BenjaminHab/mad-fine-scale/hardware/Scale.kicad_pcb

## KiCad design hardware/Scale.kicad_pcb (2025-12-04)

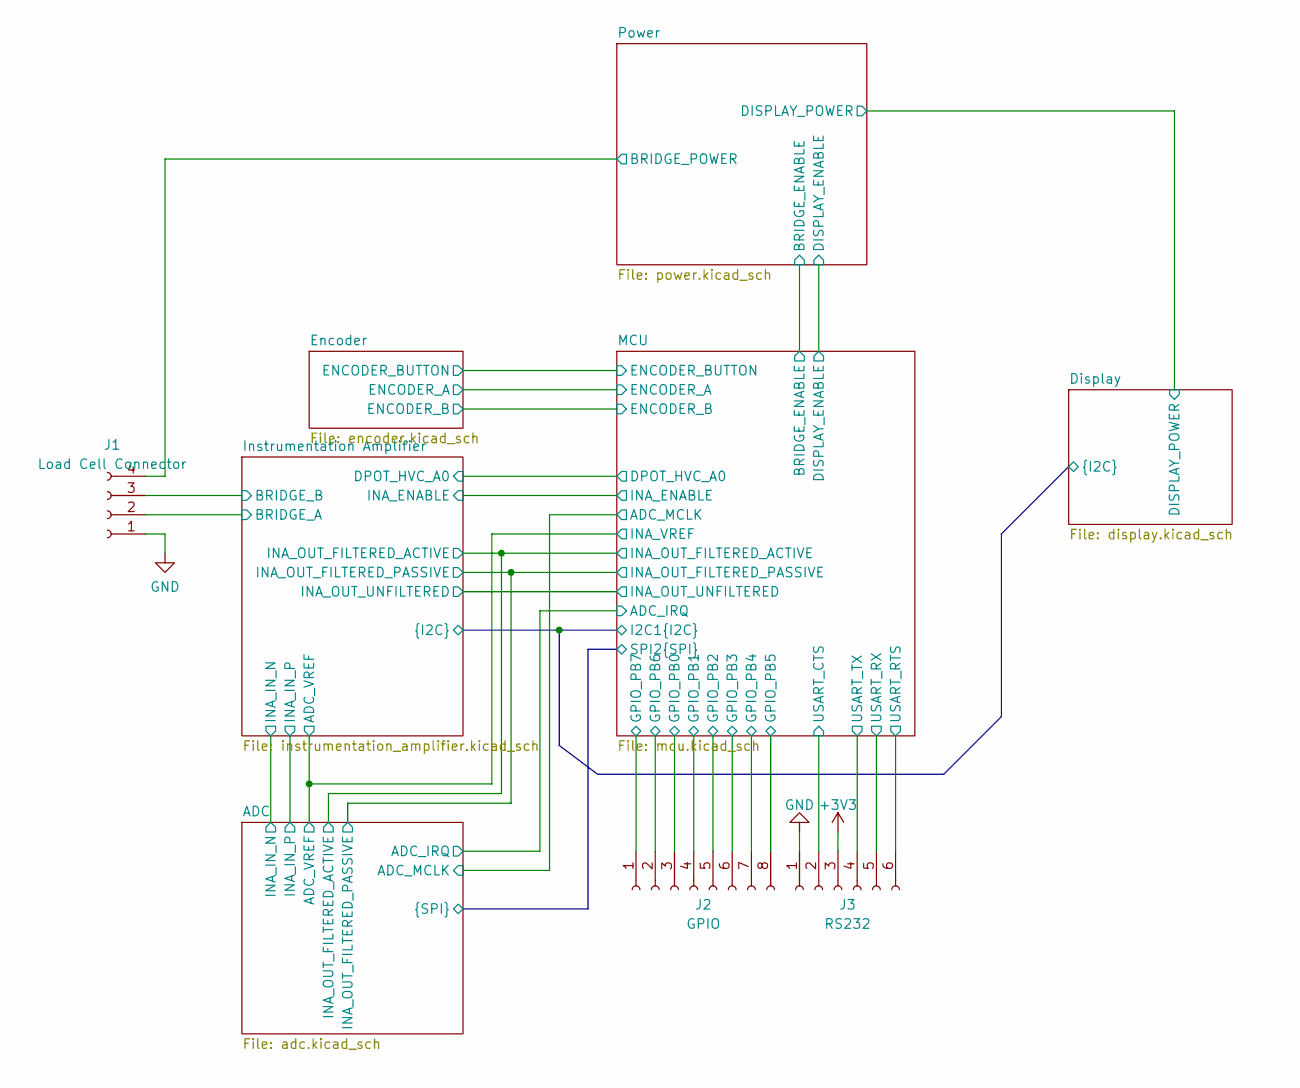
[picture p1: schematic Scale.kicad_sch]

Parts:
J1: Load Cell Connector; PinHeader_1x04_P2.54mm_Vertical
J2: GPIO; PinHeader_1x08_P2.54mm_Vertical
J3: RS232; PinHeader_1x06_P2.54mm_Vertical

Connections:
+3V3: J3.3; also elsewhere on the board
/Instrumentation Amplifier/BRIDGE_A: J1.2; also elsewhere on the board
/Instrumentation Amplifier/BRIDGE_B: J1.3; also elsewhere on the board
/MCU/GPIO_PB0: J2.3; also elsewhere on the board
/MCU/GPIO_PB1: J2.4; also elsewhere on the board
/MCU/GPIO_PB2: J2.5; also elsewhere on the board
/MCU/GPIO_PB3: J2.6; also elsewhere on the board
/MCU/GPIO_PB4: J2.7; also elsewhere on the board
/MCU/GPIO_PB5: J2.8; also elsewhere on the board
/MCU/GPIO_PB6: J2.2; also elsewhere on the board
/MCU/GPIO_PB7: J2.1; also elsewhere on the board
/MCU/USART_CTS: J3.2; also elsewhere on the board
/MCU/USART_RTS: J3.6; also elsewhere on the board
/MCU/USART_RX: J3.5; also elsewhere on the board
/MCU/USART_TX: J3.4; also elsewhere on the board
/Power/BRIDGE_POWER: J1.4; also elsewhere on the board
GND: J1.1, J3.1; also elsewhere on the board

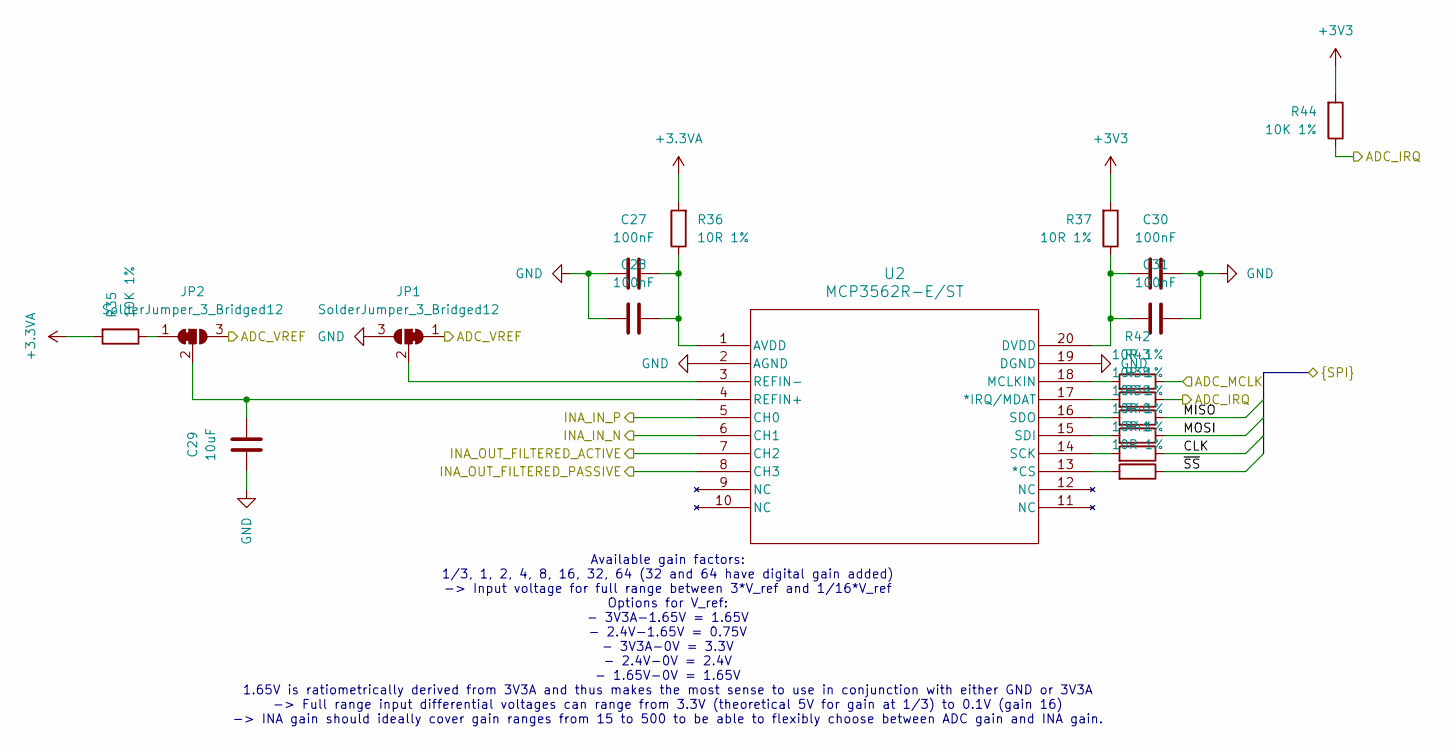
[picture p2: schematic adc.kicad_sch]

Parts:
C27, C28, C30, C31: 100nF; C_0603_1608Metric
C29: 10uF; C_0603_1608Metric
JP1, JP2: SolderJumper_3_Bridged12; SolderJumper-3_P1.3mm_Bridged2Bar12_RoundedPad1.0x1.5mm
R35, R44: 10K 1%; R_0603_1608Metric
R36, R37, R38, R39, R40, R41, R42, R43: 10R 1%; R_0603_1608Metric
U2: MCP3562R-E/ST; TSSOP-20_4.4x6.5mm_P0.65mm

Connections:
+3.3VA: R35.2, R36.2; also elsewhere on the board
+3V3: R37.2, R44.2; also elsewhere on the board
/ADC/ADC_IRQ: R43.1, R44.1; also elsewhere on the board
/ADC/ADC_MCLK: R42.1; also elsewhere on the board
/ADC/ADC_VREF: JP1.1 (A), JP2.3 (B); also elsewhere on the board
/ADC/CLK: R40.1; also elsewhere on the board
/ADC/INA_OUT_FILTERED_ACTIVE: U2.7 (CH2); also elsewhere on the board
/ADC/INA_OUT_FILTERED_PASSIVE: U2.8 (CH3); also elsewhere on the board
/ADC/MISO: R38.1; also elsewhere on the board
/ADC/MOSI: R39.1; also elsewhere on the board
/ADC/~SS: R41.1; also elsewhere on the board
/Instrumentation Amplifier/INA_IN_N: U2.6 (CH1); also elsewhere on the board
/Instrumentation Amplifier/INA_IN_P: U2.5 (CH0); also elsewhere on the board
GND: C27.1, C28.1, C29.1, C30.1, C31.1, JP1.3 (B), U2.2 (AGND), U2.19 (DGND); also elsewhere on the board
unnamed: JP1.2 (C), U2.3 (REFIN-)
unnamed: JP2.1 (A), R35.1
unnamed: C29.2, JP2.2 (C), U2.4 (REFIN+)
unnamed: R41.2, U2.13 (*CS)
unnamed: R43.2, U2.17 (*IRQ/MDAT)
unnamed: C27.2, C28.2, R36.1, U2.1 (AVDD)
unnamed: C30.2, C31.2, R37.1, U2.20 (DVDD)
unnamed: R42.2, U2.18 (MCLKIN)
unnamed: R40.2, U2.14 (SCK)
unnamed: R39.2, U2.15 (SDI)
unnamed: R38.2, U2.16 (SDO)

Notes on the sheet:
Available gain factors: 1/3, 1, 2, 4, 8, 16, 32, 64 (32 and 64 have digital gain added) -> Input voltage for full range between 3*V_ref and 1/16*V_ref Options for V_ref: - 3V3A-1.65V = 1.65V - 2.4V-1.65V = 0.75V - 3V3A-0V = 3.3V - 2.4V-0V = 2.4V - 1.65V-0V = 1.65V 1.65V is ratiometrically derived f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

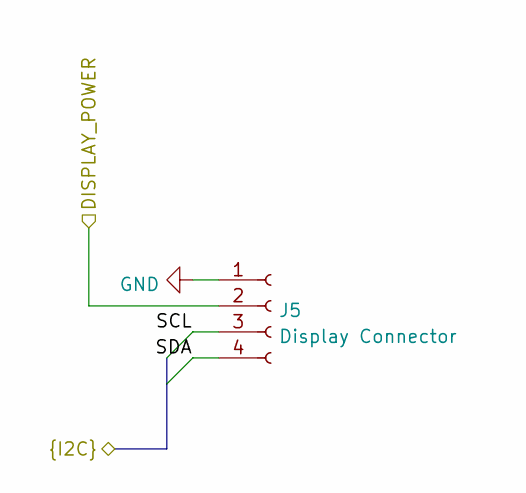
[picture p3: schematic display.kicad_sch]

Parts:
J5: Display Connector; PinHeader_1x04_P2.54mm_Vertical

Connections:
/Display/DISPLAY_POWER: J5.2; also elsewhere on the board
/Display/SCL: J5.3; also elsewhere on the board
/Display/SDA: J5.4; also elsewhere on the board
GND: J5.1; also elsewhere on the board

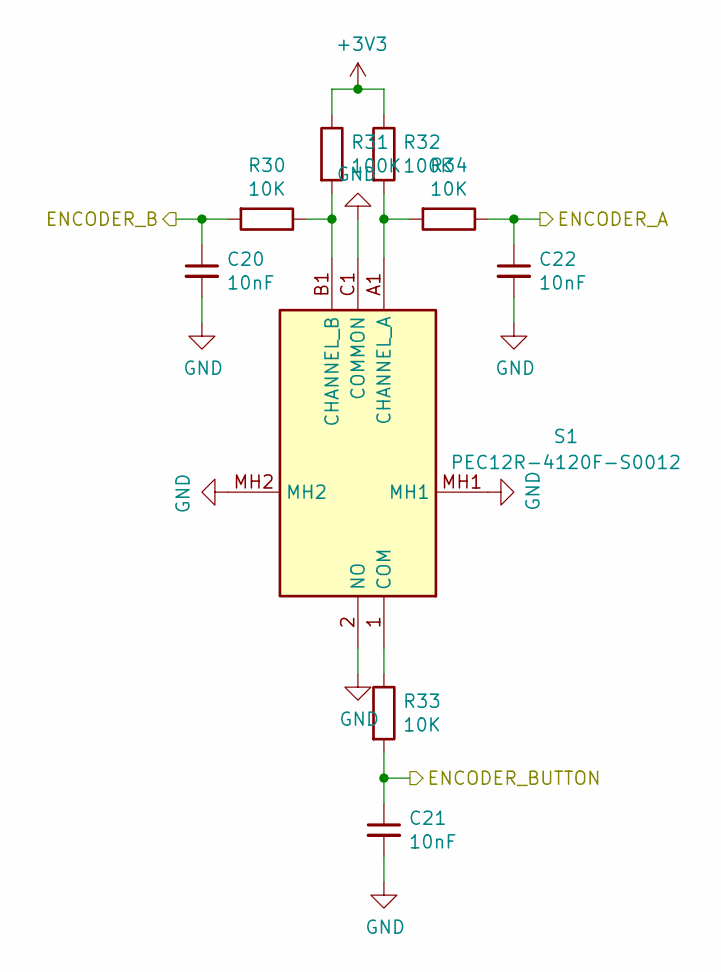
[picture p4: schematic encoder.kicad_sch]

Parts:
C20, C21, C22: 10nF; C_0603_1608Metric
R30, R33, R34: 10K; R_0603_1608Metric
R31, R32: 100K; R_0603_1608Metric
S1: PEC12R-4120F-S0012; PEC12R3217FS0024; Manufacturer_Part_Number PEC12R-3217F-S0024; Mouser Part Number 652-PEC12R3217FS0024

Connections:
+3V3: R31.1, R32.1; also elsewhere on the board
/Encoder/ENCODER_A: C22.1, R34.1; also elsewhere on the board
/Encoder/ENCODER_B: C20.1, R30.2; also elsewhere on the board
/Encoder/ENCODER_BUTTON: C21.1, R33.2; also elsewhere on the board
GND: C20.2, C21.2, C22.2, S1.2 (NO), S1.C1 (COMMON), S1.MH1, S1.MH2; also elsewhere on the board
unnamed: R32.2, R34.2, S1.A1 (CHANNEL_A)
unnamed: R30.1, R31.2, S1.B1 (CHANNEL_B)
unnamed: R33.1, S1.1 (COM)

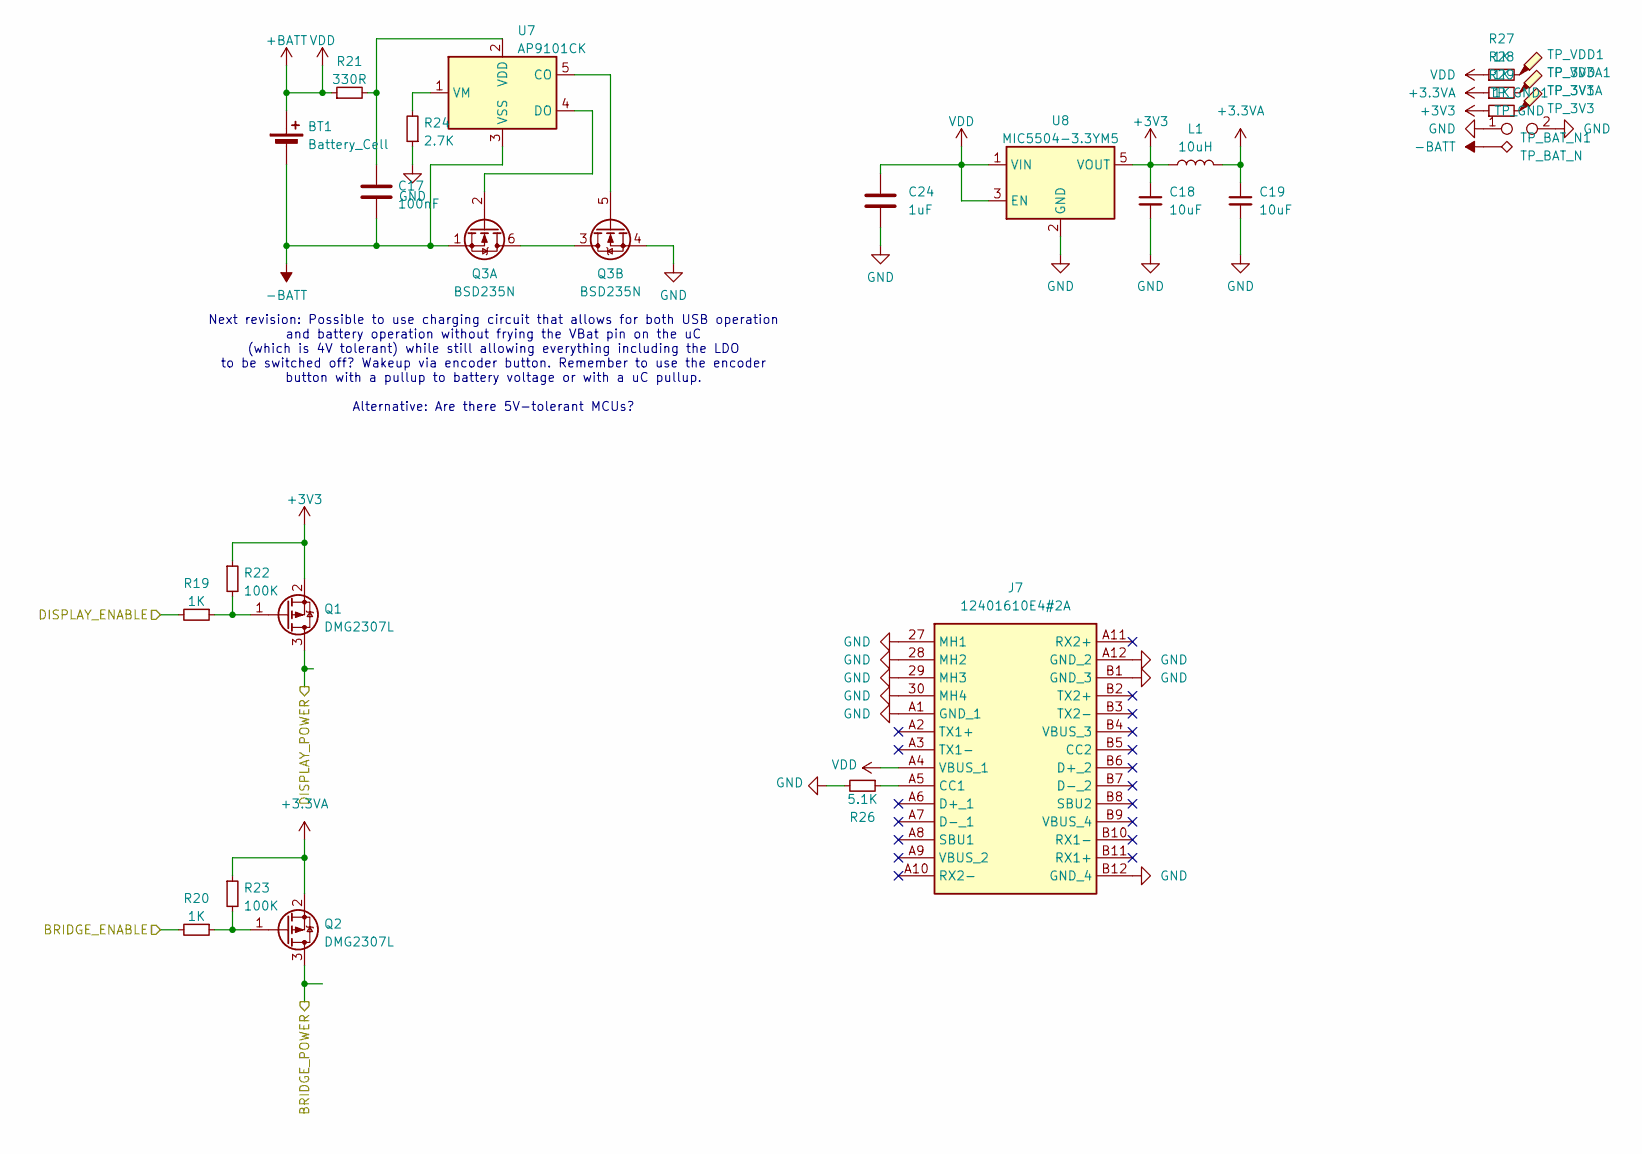
[picture p5: schematic power.kicad_sch]

Parts:
BT1: Battery_Cell; JST_PH_B2B-PH-K_1x02_P2.00mm_Vertical
C17: 100nF; C_0603_1608Metric
C18, C19: 10uF; C_1210_3225Metric
C24: 1uF; C_0603_1608Metric
J7: 12401610E4#2A; 12401610E42A; Manufacturer_Part_Number 12401610E4#2A
L1: 10uH; L_1210_3225Metric
Q1, Q2: DMG2307L; SOT-23
Q3: BSD235N; SOT-363_SC-70-6; MPN BSD235N
R19, R20, R27, R28, R29: 1K; R_0603_1608Metric
R21: 330R; R_0603_1608Metric
R22, R23: 100K; R_0603_1608Metric
R24: 2.7K; R_0603_1608Metric
R26: 5.1K; R_0603_1608Metric
TP_3V1: TP_3V3; TestPoint_Pad_D1.5mm
TP_3V3A1: TP_3V3A; TestPoint_Pad_D1.5mm
TP_BAT_N1: TP_BAT_N; TestPoint_Pad_D1.5mm
TP_GND1: TP_GND; R_0805_2012Metric
TP_VDD1: TP_VDD; TestPoint_Pad_D1.5mm
U7: AP9101CK; SOT-23-5; MPN AP9101CK-AHTRG1
U8: MIC5504-3.3YM5; SOT-23-5; MPN MIC5504-3.3YM5-TR

Connections:
+3.3VA: C19.1, L1.2, Q2.2 (S), R23.1, R28.1; also elsewhere on the board
+3V3: C18.1, L1.1, Q1.2 (S), R22.1, R29.1, U8.5 (VOUT); also elsewhere on the board
+BATT: BT1.1 (+), C24.2, J7.A4 (VBUS_1), R21.1, R27.1, U8.1 (VIN), U8.3 (EN)
-BATT: BT1.2 (-), C17.2, Q3.1 (S), TP_BAT_N1.1, U7.3 (VSS)
/Display/DISPLAY_POWER: Q1.3 (D); also elsewhere on the board
/MCU/BRIDGE_ENABLE: R20.2; also elsewhere on the board
/MCU/DISPLAY_ENABLE: R19.2; also elsewhere on the board
/Power/BRIDGE_POWER: Q2.3 (D); also elsewhere on the board
GND: C18.2, C19.2, C24.1, J7.27 (MH1), J7.28 (MH2), J7.29 (MH3), J7.30 (MH4), J7.A1 (GND_1), J7.A12 (GND_2), J7.B1 (GND_3), J7.B12 (GND_4), Q3.4 (S), R24.1, R26.2, TP_GND1.1, TP_GND1.2, U8.2 (GND); also elsewhere on the board
unnamed: J7.A5 (CC1), R26.1
unnamed: Q1.1 (G), R19.1, R22.2
unnamed: Q2.1 (G), R20.1, R23.2
unnamed: Q3.3 (D), Q3.6 (D)
unnamed: Q3.2 (G), U7.4 (DO)
unnamed: Q3.5 (G), U7.5 (CO)
unnamed: R27.2, TP_VDD1.1
unnamed: R28.2, TP_3V3A1.1
unnamed: R29.2, TP_3V1.1
unnamed: C17.1, R21.2, U7.2 (VDD)
unnamed: R24.2, U7.1 (VM)

Notes on the sheet:
Next revision: Possible to use charging circuit that allows for both USB operation and battery operation without frying the VBat pin on the uC (which is 4V tolerant) while still allowing everything including the LDO to be switched off? Wakeup via encoder button. Remember to use the encoder button w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

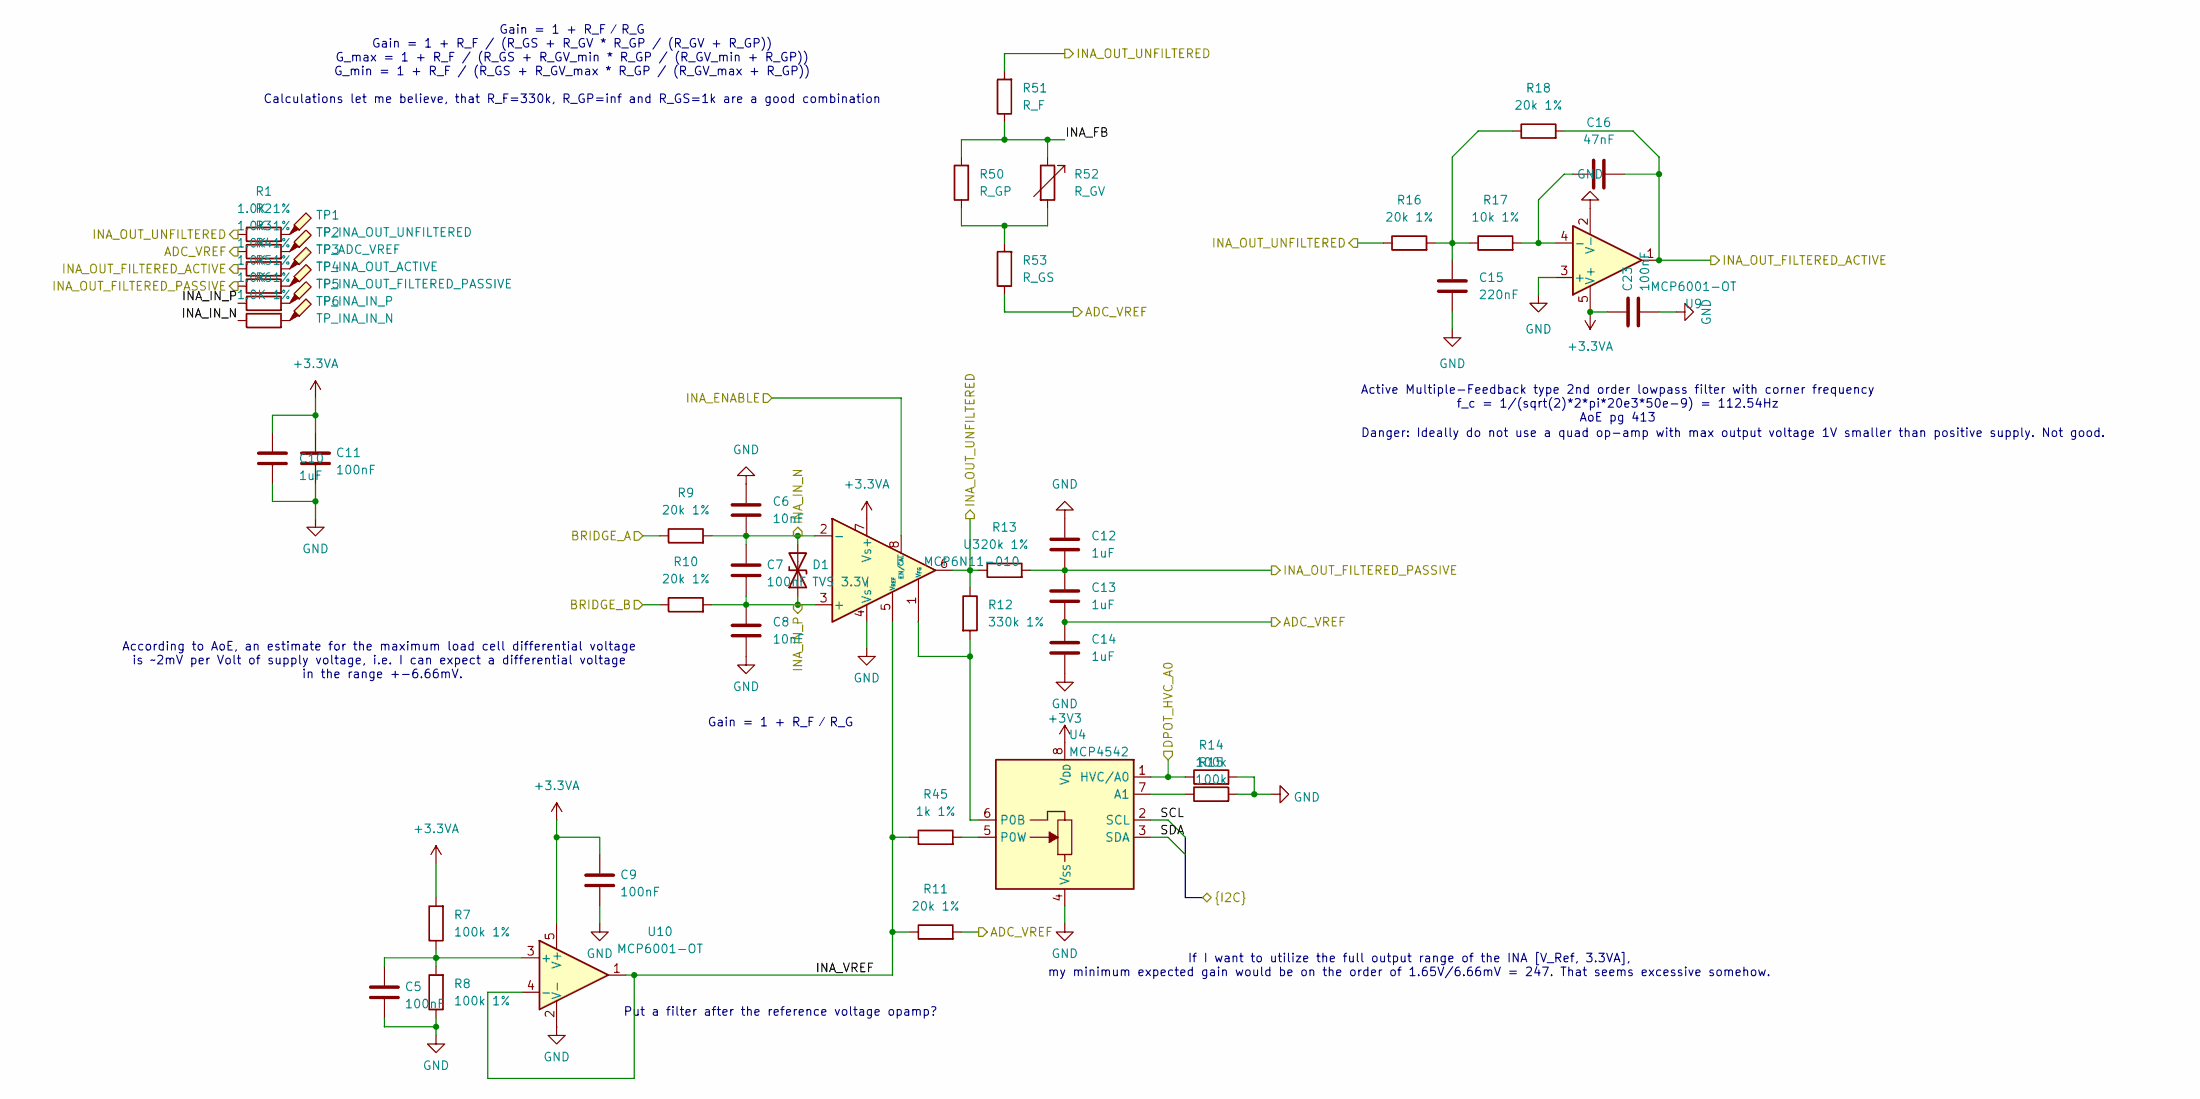
[picture p6: schematic instrumentation_amplifier.kicad_sch]

Parts:
C5, C7, C9, C11, C23: 100nF; C_0603_1608Metric
C6, C8: 10nF; C_0603_1608Metric
C10, C12, C13, C14: 1uF; C_0603_1608Metric
C15: 220nF; C_0603_1608Metric
C16: 47nF; C_0603_1608Metric
D1: TVS 3.3V; D_SOD-323F; MPN CDSOD323-T03
R1, R2, R3, R4, R5, R6: 1.0K 1%; R_0603_1608Metric
R7, R8: 100k 1%; R_0603_1608Metric
R9, R10, R11, R13, R16, R18: 20k 1%; R_0603_1608Metric
R12: 330k 1%; R_0603_1608Metric
R14, R15: 100k; R_0603_1608Metric
R17: 10k 1%; R_0603_1608Metric
R45: 1k 1%; R_0603_1608Metric
R50: R_GP; R_0603_1608Metric
R51: R_F; R_0603_1608Metric
R52: R_GV
R53: R_GS; R_0603_1608Metric
TP1: TP_INA_OUT_UNFILTERED; TestPoint_Pad_D1.5mm
TP2: TP_ADC_VREF; TestPoint_Pad_D1.5mm
TP3: TP_INA_OUT_ACTIVE; TestPoint_Pad_D1.5mm
TP4: TP_INA_OUT_FILTERED_PASSIVE; TestPoint_Pad_D1.5mm
TP5: TP_INA_IN_P; TestPoint_Pad_D1.5mm
TP6: TP_INA_IN_N; TestPoint_Pad_D1.5mm
U3: MCP6N11-010; SOIC-8_3.9x4.9mm_P1.27mm; MPN MCP6N11-010
U4: MCP4542; MSOP-8_3x3mm_P0.65mm; MPN MCP4542-103E/MS
U9, U10: MCP6001-OT; SOT-23-5

Connections:
+3.3VA: C9.1, C10.1, C11.1, C23.1, R7.2, U3.7 (Vs+), U9.5 (V+), U10.5 (V+); also elsewhere on the board
+3V3: U4.8 (V_{DD}); also elsewhere on the board
/ADC/ADC_VREF: C13.2, C14.1, R2.1, R11.2, R53.1; also elsewhere on the board
/ADC/INA_OUT_FILTERED_ACTIVE: C16.2, R3.1, R18.2, U9.1; also elsewhere on the board
/ADC/INA_OUT_FILTERED_PASSIVE: C12.2, C13.1, R4.1, R13.2; also elsewhere on the board
/Display/SCL: U4.2 (SCL); also elsewhere on the board
/Display/SDA: U4.3 (SDA); also elsewhere on the board
/Instrumentation Amplifier/BRIDGE_A: R9.1; also elsewhere on the board
/Instrumentation Amplifier/BRIDGE_B: R10.1; also elsewhere on the board
/Instrumentation Amplifier/DPOT_HVC_A0: R14.1, U4.1 (HVC/A0); also elsewhere on the board
/Instrumentation Amplifier/INA_ENABLE: U3.8 (EN/~CAL); also elsewhere on the board
/Instrumentation Amplifier/INA_IN_N: C6.2, C7.1, D1.2 (A2), R6.1, R9.2, U3.2 (-); also elsewhere on the board
/Instrumentation Amplifier/INA_IN_P: C7.2, C8.1, D1.1 (A1), R5.1, R10.2, U3.3 (+); also elsewhere on the board
/Instrumentation Amplifier/INA_OUT_UNFILTERED: R1.1, R12.1, R13.1, R16.1, R51.2, U3.6; also elsewhere on the board
/Instrumentation Amplifier/INA_VREF: R11.1, R45.1, U3.5 (V_{REF}), U10.1, U10.4 (-)
GND: C5.2, C6.1, C8.2, C9.2, C10.2, C11.2, C12.1, C14.2, C15.2, C23.2, R8.1, R14.2, R15.2, U3.4 (Vs-), U4.4 (V_{SS}), U9.2 (V-), U9.3 (+), U10.2 (V-); also elsewhere on the board
unnamed: C15.1, R16.2, R17.1, R18.1
unnamed: R1.2, TP1.1
unnamed: R2.2, TP2.1
unnamed: R3.2, TP3.1
unnamed: R4.2, TP4.1
unnamed: R5.2, TP5.1
unnamed: R6.2, TP6.1
unnamed: R50.1, R52.2, R53.2
unnamed: R50.2, R51.1, R52.1
unnamed: R12.2, U3.1 (V_{FG}), U4.6 (P0B)
unnamed: R15.1, U4.7 (A1)
unnamed: R45.2, U4.5 (P0W)
unnamed: C16.1, R17.2, U9.4 (-)
unnamed: C5.1, R7.1, R8.2, U10.3 (+)

Notes on the sheet:
Gain = 1 + R_F ⁄ R_G Gain = 1 + R_F / (R_GS + R_GV * R_GP / (R_GV + R_GP)) G_max = 1 + R_F / (R_GS + R_GV_min * R_GP / (R_GV_min + R_GP)) G_min = 1 + R_F / (R_GS + R_GV_max * R_GP / (R_GV_max + R_GP)) Calculations let me believe, that R_F=330k, R_GP=inf and R_GS=1k are a good combination
According to AoE, an estimate for the maximum load cell differential voltage is ~2mV per Volt of supply voltage, i.e. I can expect a differential voltage in the range +-6.66mV.
Gain = 1 + R_F ⁄ R_G
Danger: Ideally do not use a quad op-amp with max output voltage 1V smaller than positive supply. Not good.
Put a filter after the reference voltage opamp?
If I want to utilize the full output range of the INA [V_Ref, 3.3VA], my minimum expected gain would be on the order of 1.65V/6.66mV = 247. That seems excessive somehow.
Active Multiple-Feedback type 2nd order lowpass filter with corner frequency f_c = 1/(sqrt(2)*2*pi*20e3*50e-9) = 112.54Hz AoE pg 413

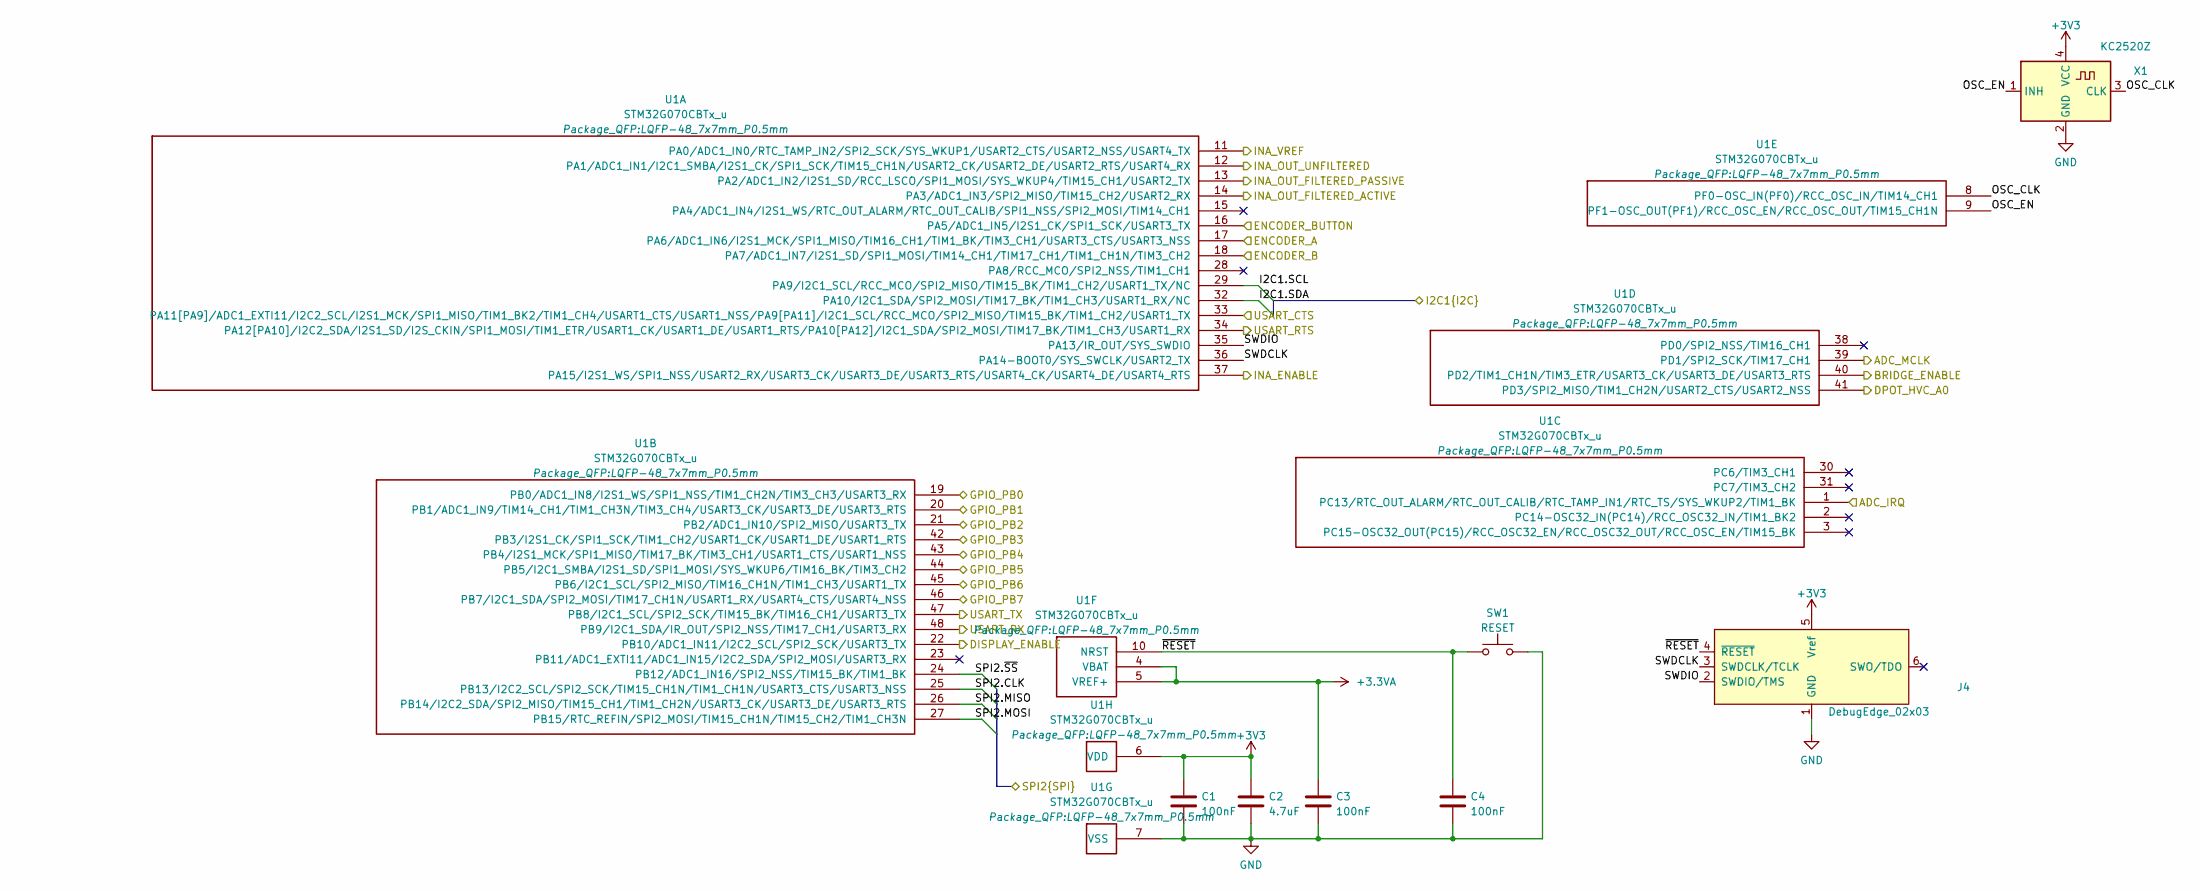
[picture p7: schematic mcu.kicad_sch]

Parts:
C1, C3, C4: 100nF; C_0603_1608Metric
C2: 4.7uF; C_0603_1608Metric
J4: DebugEdge_02x03; DebugEdge_2x03_Target
SW1: RESET; SW_Push_1P1T_NO_CK_KMR2
U1: STM32G070CBTx_u; LQFP-48_7x7mm_P0.5mm
X1: KC2520Z; Oscillator_SMD_Kyocera_KC2520Z-4Pin_2.5x2.0mm; MPN KC2520Z48.0000C1KX00

Connections:
+3.3VA: C3.1, U1.4 (VBAT), U1.5 (VREF+); also elsewhere on the board
+3V3: C1.1, C2.1, J4.5 (Vref), U1.6 (VDD), X1.4 (VCC); also elsewhere on the board
/ADC/ADC_IRQ: U1.1 (PC13/RTC_OUT_ALARM/RTC_OUT_CALIB/RTC_TA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); also elsewhere on the board
/ADC/ADC_MCLK: U1.39 (PD1/SPI2_SCK/TIM17_CH1); also elsewhere on the board
/ADC/ADC_VREF: U1.11 (PA0/ADC1_IN0/RTC_TAMP_IN2/SPI2_SCK/SYS_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); also elsewhere on the board
/ADC/CLK: U1.25 (PB13/I2C2_SCL/SPI2_SCK/TIM15_CH1N/TIM1_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); also elsewhere on the board
/ADC/INA_OUT_FILTERED_ACTIVE: U1.14 (PA3/ADC1_IN3/SPI2_MISO/TIM15_CH2/USART2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); also elsewhere on the board
/ADC/INA_OUT_FILTERED_PASSIVE: U1.13 (PA2/ADC1_IN2/I2S1_SD/RCC_LSCO/SPI1_MOSI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); also elsewhere on the board
/ADC/MISO: U1.26 (PB14/I2C2_SDA/SPI2_MISO/TIM15_CH1/TIM1_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); also elsewhere on the board
/ADC/MOSI: U1.27 (PB15/RTC_REFIN/SPI2_MOSI/TIM15_CH1N/TIM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); also elsewhere on the board
/ADC/~SS: U1.24 (PB12/ADC1_IN16/SPI2_NSS/TIM15_BK/TIM1_BK); also elsewhere on the board
/Display/SCL: U1.29 (PA9/I2C1_SCL/RCC_MCO/SPI2_MISO/TIM15_BK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); also elsewhere on the board
/Display/SDA: U1.32 (PA10/I2C1_SDA/SPI2_MOSI/TIM17_BK/TIM1_C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); also elsewhere on the board
/Encoder/ENCODER_A: U1.17 (PA6/ADC1_IN6/I2S1_MCK/SPI1_MISO/TIM16_C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); also elsewhere on the board
/Encoder/ENCODER_B: U1.18 (PA7/ADC1_IN7/I2S1_SD/SPI1_MOSI/TIM14_CH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); also elsewhere on the board
/Encoder/ENCODER_BUTTON: U1.16 (PA5/ADC1_IN5/I2S1_CK/SPI1_SCK/USART3_TX); also elsewhere on the board
/Instrumentation Amplifier/DPOT_HVC_A0: U1.41 (PD3/SPI2_MISO/TIM1_CH2N/USART2_CTS/USAR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); also elsewhere on the board
/Instrumentation Amplifier/INA_ENABLE: U1.37 (PA15/I2S1_WS/SPI1_NSS/USART2_RX/USART3_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); also elsewhere on the board
/Instrumentation Amplifier/INA_OUT_UNFILTERED: U1.12 (PA1/ADC1_IN1/I2C1_SMBA/I2S1_CK/SPI1_SCK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); also elsewhere on the board
/MCU/BRIDGE_ENABLE: U1.40 (PD2/TIM1_CH1N/TIM3_ETR/USART3_CK/USART3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); also elsewhere on the board
/MCU/DISPLAY_ENABLE: U1.22 (PB10/ADC1_IN11/I2C2_SCL/SPI2_SCK/USART3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); also elsewhere on the board
/MCU/GPIO_PB0: U1.19 (PB0/ADC1_IN8/I2S1_WS/SPI1_NSS/TIM1_CH2N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); also elsewhere on the board
/MCU/GPIO_PB1: U1.20 (PB1/ADC1_IN9/TIM14_CH1/TIM1_CH3N/TIM3_C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); also elsewhere on the board
/MCU/GPIO_PB2: U1.21 (PB2/ADC1_IN10/SPI2_MISO/USART3_TX); also elsewhere on the board
/MCU/GPIO_PB3: U1.42 (PB3/I2S1_CK/SPI1_SCK/TIM1_CH2/USART1_CK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); also elsewhere on the board
/MCU/GPIO_PB4: U1.43 (PB4/I2S1_MCK/SPI1_MISO/TIM17_BK/TIM3_CH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); also elsewhere on the board
/MCU/GPIO_PB5: U1.44 (PB5/I2C1_SMBA/I2S1_SD/SPI1_MOSI/SYS_WKU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); also elsewhere on the board
/MCU/GPIO_PB6: U1.45 (PB6/I2C1_SCL/SPI2_MISO/TIM16_CH1N/TIM1_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); also elsewhere on the board
/MCU/GPIO_PB7: U1.46 (PB7/I2C1_SDA/SPI2_MOSI/TIM17_CH1N/USART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); also elsewhere on the board
/MCU/OSC_CLK: U1.8 (PF0-OSC_IN(PF0)/RCC_OSC_IN/TIM14_CH1), X1.3 (CLK)
/MCU/OSC_EN: U1.9 (PF1-OSC_OUT(PF1)/RCC_OSC_EN/RCC_OSC_OUT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), X1.1 (INH)
/MCU/SWDCLK: J4.3 (SWDCLK/TCLK), U1.36 (PA14-BOOT0/SYS_SWCLK/USART2_TX)
/MCU/SWDIO: J4.2 (SWDIO/TMS), U1.35 (PA13/IR_OUT/SYS_SWDIO)
/MCU/USART_CTS: U1.33 (PA11[PA9]/ADC1_EXTI11/I2C2_SCL/I2S1_MCK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); also elsewhere on the board
/MCU/USART_RTS: U1.34 (PA12[PA10]/I2C2_SDA/I2S1_SD/I2S_CKIN/SP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); also elsewhere on the board
/MCU/USART_RX: U1.48 (PB9/I2C1_SDA/IR_OUT/SPI2_NSS/TIM17_CH1/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); also elsewhere on the board
/MCU/USART_TX: U1.47 (PB8/I2C1_SCL/SPI2_SCK/TIM15_BK/TIM16_CH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); also elsewhere on the board
/MCU/~RESET: C4.1, J4.4 (~RESET), SW1.1, U1.10 (NRST)
GND: C1.2, C2.2, C3.2, C4.2, J4.1 (GND), SW1.2, U1.7 (VSS), X1.2 (GND); also elsewhere on the board

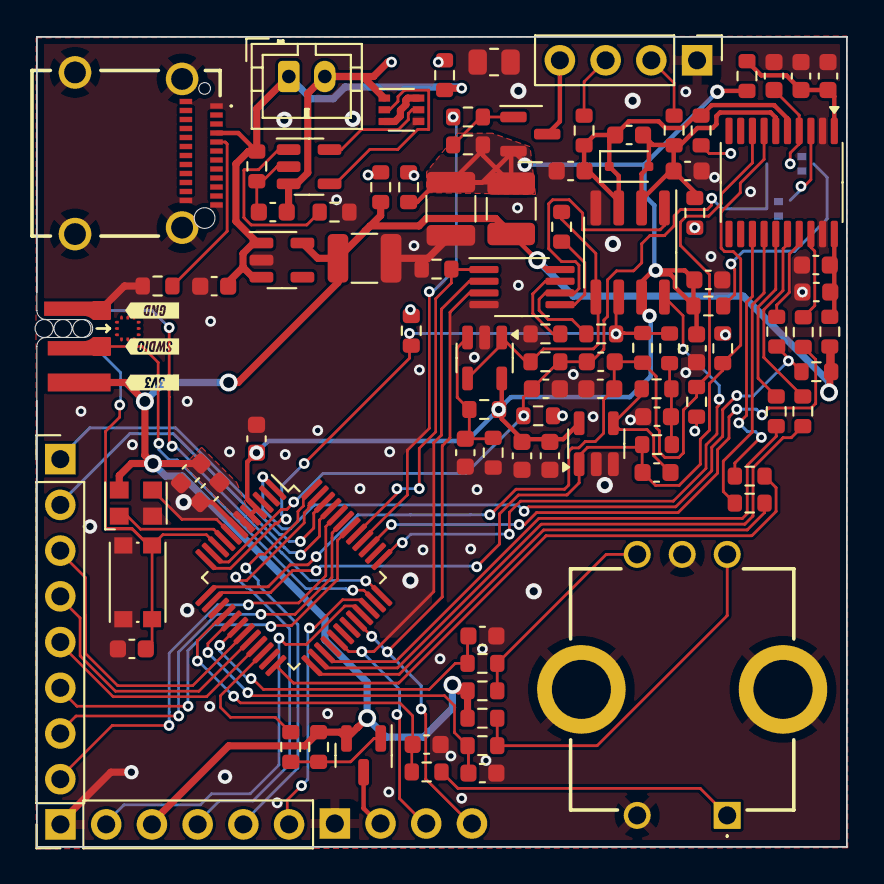
[picture p8: board Scale.kicad_pcb from above]

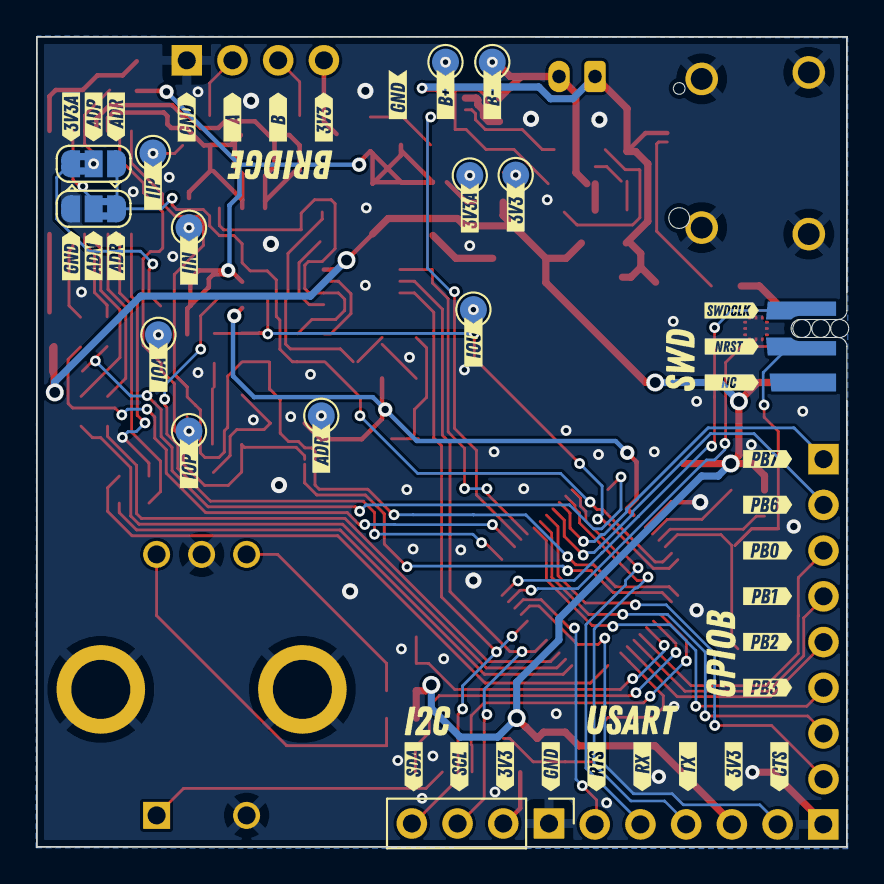
[picture p9: board Scale.kicad_pcb from below]

Board: 2 copper layers, 45.0 x 45.0 mm, 158 parts (59 on the bottom side), 85 nets.

Other parts of the board:
kibuzzard-69235A0F: G***; kibuzzard-69235A0F
kibuzzard-69235A05: G***; kibuzzard-69235A05
kibuzzard-69235A65: G***; kibuzzard-69235A65
kibuzzard-69235A78: G***; kibuzzard-69235A78
kibuzzard-69235A81: G***; kibuzzard-69235A81
kibuzzard-69235C2C: G***; kibuzzard-69235C2C
kibuzzard-69235C3D: G***; kibuzzard-69235C3D
kibuzzard-69235C19: G***; kibuzzard-69235C19
kibuzzard-69235C25: G***; kibuzzard-69235C25
kibuzzard-69235C31: G***; kibuzzard-69235C31
kibuzzard-69235C43: G***; kibuzzard-69235C43
kibuzzard-69235C86: G***; kibuzzard-69235C86
kibuzzard-69235CAB: G***; kibuzzard-69235CAB
kibuzzard-69235CD0: G***; kibuzzard-69235CD0
kibuzzard-69235CE7: G***; kibuzzard-69235CE7
kibuzzard-69235D1A: G***; kibuzzard-69235D1A
kibuzzard-69235D2C: G***; kibuzzard-69235D2C
kibuzzard-69235D7B: G***; kibuzzard-69235D7B
kibuzzard-69235D46: G***; kibuzzard-69235D46
kibuzzard-69235D61: G***; kibuzzard-69235D61
kibuzzard-69235D70: G***; kibuzzard-69235D70
kibuzzard-69235D86: G***; kibuzzard-69235D86
kibuzzard-69235DBF: G***; kibuzzard-69235DBF
kibuzzard-69235DD0: G***; kibuzzard-69235DD0
kibuzzard-69235DDD: G***; kibuzzard-69235DDD
kibuzzard-69235DE8: G***; kibuzzard-69235DE8
kibuzzard-69235E1A: G***; kibuzzard-69235E1A
kibuzzard-69235E07: G***; kibuzzard-69235E07
kibuzzard-69235E34: G***; kibuzzard-69235E34
kibuzzard-69235E43: G***; kibuzzard-69235E43
kibuzzard-69235E53: G***; kibuzzard-69235E53
kibuzzard-69235E66: G***; kibuzzard-69235E66
kibuzzard-69235E74: G***; kibuzzard-69235E74
kibuzzard-69235E84: G***; kibuzzard-69235E84
kibuzzard-69235EA0: G***; kibuzzard-69235EA0
kibuzzard-69235EC4: G***; kibuzzard-69235EC4
kibuzzard-69235ED0: G***; kibuzzard-69235ED0
kibuzzard-69235EDC: G***; kibuzzard-69235EDC
kibuzzard-69235EE8: G***; kibuzzard-69235EE8
kibuzzard-69235EF4: G***; kibuzzard-69235EF4
kibuzzard-69235F49: G***; kibuzzard-69235F49
kibuzzard-69235FA0: G***; kibuzzard-69235FA0
kibuzzard-69235FE1: G***; kibuzzard-69235FE1
kibuzzard-692359F1: G***; kibuzzard-692359F1
kibuzzard-692360F1: G***; kibuzzard-692360F1
kibuzzard-69236006: G***; kibuzzard-69236006
kibuzzard-69236027: G***; kibuzzard-69236027
kibuzzard-69236067: G***; kibuzzard-69236067
kibuzzard-69236118: G***; kibuzzard-69236118
