BenjaminHab/mad-fine-scale/software/Core/Inc/main.h

#define ENCODER_BUTTON_Pin GPIO_PIN_0
#define ENCODER_BUTTON_GPIO_Port GPIOA
#define INA_OUT_Pin GPIO_PIN_1
#define INA_OUT_GPIO_Port GPIOA
#define DISPLAY_ENABLE_Pin GPIO_PIN_2
#define DISPLAY_ENABLE_GPIO_Port GPIOA
#define BRIDGE_ENABLE_Pin GPIO_PIN_3
#define BRIDGE_ENABLE_GPIO_Port GPIOA
#define DPOT_HVC_A0_Pin GPIO_PIN_4
#define DPOT_HVC_A0_GPIO_Port GPIOA
#define GPIO_PA5_Pin GPIO_PIN_5
#define GPIO_PA5_GPIO_Port GPIOA
#define ENCODER_A_Pin GPIO_PIN_6
#define ENCODER_A_GPIO_Port GPIOA
#define ENCODER_B_Pin GPIO_PIN_7
#define ENCODER_B_GPIO_Port GPIOA
#define GPIO_PB0_Pin GPIO_PIN_0
#define GPIO_PB0_GPIO_Port GPIOB
#define GPIO_PB1_Pin GPIO_PIN_1
#define GPIO_PB1_GPIO_Port GPIOB
#define GPIO_PB2_Pin GPIO_PIN_2
#define GPIO_PB2_GPIO_Port GPIOB
#define GPIO_PA8_Pin GPIO_PIN_8
#define GPIO_PA8_GPIO_Port GPIOA
#define INA_ENABLE_Pin GPIO_PIN_15
#define INA_ENABLE_GPIO_Port GPIOA
#define GPIO_PB3_Pin GPIO_PIN_3
#define GPIO_PB3_GPIO_Port GPIOB
#define GPIO_PB4_Pin GPIO_PIN_4
#define GPIO_PB4_GPIO_Port GPIOB
#define GPIO_PB5_Pin GPIO_PIN_5
#define GPIO_PB5_GPIO_Port GPIOB
