BenjaminHab/mad-fine-scale/software/Core/Src/main.cpp

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
/* Includes ------------------------------------------------------------------*/
#include "main.h"
#include "adc.h"
#include "i2c.h"
#include "tim.h"
#include "usart.h"
#include "gpio.h"

/* USER CODE BEGIN Includes */
#include "Modules.hpp"
/* USER CODE END Includes */


void SystemClock_Config(void);
/**
  * @brief  The application entry point.
  * @retval int
  */
int main(void)
{
  /* MCU Configuration--------------------------------------------------------*/

  /* Reset of all peripherals, Initializes the Flash interface and the Systick. */
  HAL_Init();

  /* Configure the system clock */
  SystemClock_Config();

  /* Initialize all configured peripherals */
  MX_GPIO_Init();
  MX_TIM3_Init();
  MX_I2C1_Init();
  MX_ADC1_Init();
  MX_USART1_UART_Init();
  /* USER CODE BEGIN 2 */
  HAL_GPIO_WritePin(DPOT_HVC_A0_GPIO_Port, DPOT_HVC_A0_Pin, GPIO_PIN_RESET); // Set A0 pin on the digital potentiometer to get the correct i2c address
  HAL_GPIO_WritePin(DISPLAY_ENABLE_GPIO_Port, DISPLAY_ENABLE_Pin, GPIO_PIN_RESET); // Switch on power for display (pmos -> inv. signal)
  HAL_GPIO_WritePin(BRIDGE_ENABLE_GPIO_Port, BRIDGE_ENABLE_Pin, GPIO_PIN_RESET); // Switch on power for wheatstone bridge (pmos -> inv. signal)
  HAL_GPIO_WritePin(INA_ENABLE_GPIO_Port, INA_ENABLE_Pin, GPIO_PIN_RESET); // Switch off power for instrumentation amp
  HAL_Delay(10);
  HAL_GPIO_WritePin(INA_ENABLE_GPIO_Port, INA_ENABLE_Pin, GPIO_PIN_SET); // Switch on power for instrumentation amp
  HAL_Delay(100);
  //Display_Test display_test;
  ADC_Test adc_test;
  /* USER CODE END 2 */

  /* Infinite loop */
  /* USER CODE BEGIN WHILE */
  while (1)
  {
	  adc_test.perform();
    /* USER CODE END WHILE */

    /* USER CODE BEGIN 3 */
  }
  /* USER CODE END 3 */
}

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
