BenjaminHab/mad-fine-scale/software/Core/Inc/Modules.hpp

#ifndef Modules_hpp
#define Modules_hpp

#include "ADC_Module.hpp"
#include "Menu_Module.hpp"
#include "Display_Module.hpp"
#include "Encoder_Module.hpp"
#include "GPIO_Module.hpp"
#include "Init_Modules.hpp"
#include "LED_Module.hpp"
#include "Peripherals_Module.hpp"
#include "Statemachine_Module.hpp"
#include "Test_Module.hpp"
#include "RCC_Module.hpp"

#endif
