BenjaminHab/mad-fine-scale/(commit log)

2022-06-05 Fixed Display: At fault was the output speed of the i2c pins
    [Init_Modules.cpp, Test_Module.cpp, mad-fine-scale.ioc]
2024-03-01 Removed build files from index, first experiments with rust
    [Scale-Edge_Cuts.dxf, Scale-F_Paste.dxf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]
2025-07-11 Add todos and try to talk to rheo on i2c
2025-07-14 Fix compiler warning about unused results
    [main.rs]
2025-07-14 Get I2C with rheo working
2025-08-10 Added justification for reference voltage
2025-08-12 Updated schematic according to reference design
    [Scale.kicad_sch, display.kicad_sch, encoder.kicad_sch, instrumentation_amplifier.kicad_sch, mcu.kicad_sch, power.kicad_sch]
2025-11-03 Include active filter, ext. ADC, changes to power supply
    [Scale.kicad_sch, instrumentation_amplifier.kicad_sch, mcu.kicad_sch, power.kicad_sch]
2025-11-03 Added correct symbol and libraries for ADC
    [Scale.kicad_sch, display.kicad_sch, encoder.kicad_sch, instrumentation_amplifier.kicad_sch, mcu.kicad_sch, power.kicad_sch]
2025-11-12 Regenerated reference designators, changed to rail-to-rail op-amps
    [Scale.kicad_sch, display.kicad_sch, encoder.kicad_sch, instrumentation_amplifier.kicad_sch, mcu.kicad_sch, power.kicad_sch]
2025-11-17 Add KiCad-specific .gitignore
2025-11-17 Add ADC datasheet and reference design
2025-11-17 Major changes to schematic
    [adc.kicad_sch, display.kicad_sch, encoder.kicad_sch, instrumentation_amplifier.kicad_sch, mcu.kicad_sch, power.kicad_sch]
2025-11-17 Started on pcb
    [Scale.kicad_pcb, Scale.kicad_sch]
2025-11-17 Added solder bridges and calculated resistor values for INA
    [Scale.kicad_pcb, adc.kicad_sch, instrumentation_amplifier.kicad_sch, power.kicad_sch]
2025-11-17 Set jumper footprints and updated design rules for Oshpark After Dark
    [Scale.kicad_pcb, adc.kicad_sch, power.kicad_sch]
2025-11-18 Added battery protection IC datasheet
2025-11-18 Realized that 5V to VBat pin would fry the uC and abandoned ultra-low power design. Deferred to next revision.
    A
    A
    A
    A
    A
    A
    A
    A
    A
    A
    A
    A
    A
    A
    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
    [instrumentation_amplifier.kicad_sch, mcu.kicad_sch, power.kicad_sch]
2025-11-18 Some more routing
    [Scale.kicad_pcb, Scale.kicad_sch, mcu.kicad_sch]
2025-11-21 Ran electrical check on schematic and implemented corrections
    [Scale.kicad_sch, instrumentation_amplifier.kicad_sch, mcu.kicad_sch]
2025-11-21 Updated design rules and ran and implemented DRC
    [Scale.kicad_pcb]
2025-11-23 Added labels
    [Scale.kicad_pcb]
2025-11-23 Rearrange labels
    [Scale.kicad_pcb]
2025-11-27 Added test point
    [Scale.kicad_pcb, power.kicad_sch]
2025-11-27 Moved schematic and footprint to common library
2025-11-27 Removed old silkscreen design files
    [Scale-brd-backside-onlyText.dxf]
2025-11-27 Move vias to fix silkscreen
    [Scale.kicad_pcb]
2025-11-27 Fixed encoder and usb 3D models
    [Scale.kicad_pcb, encoder.kicad_sch]
2025-11-27 Fix Silkscreen
    [Scale.kicad_pcb]
2025-11-27 Embed fonts
    [Scale.kicad_pcb]
2025-11-27 Move board edge for manufacturing
    [Scale.kicad_pcb]
2025-12-02 Added net classes
    [Scale.kicad_pcb, adc.kicad_sch, instrumentation_amplifier.kicad_sch]
2025-12-04 Embassy starting point: ADC example
2025-12-04 Can build embassy adc example
2025-12-04 Can flash and attach with cargo embed
2025-12-04 Add HSE config. Blink LED. Logging still borked.
2025-12-04 Try to move towards sharing the I2C peripheral; currently borked
2025-12-04 Used example to get mutual exclusive use of I2C working
2025-12-04 Added Pluto Notebook for ADC data analysis
    [data_1_5.csv, f4.csv, g0.csv]
2025-12-04 Analyse ADC measurement problem
    [main.rs]
2025-12-04 Fixed gain calculation
    [g0.csv]
2025-12-04 Cleanup of old hardware files
    [Scale-Edge_Cuts.dxf, Scale-F_Paste.dxf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]
2025-12-04 Move to notion board
2025-12-04 Modify vscode debug config to allow debugging currently open rust file
2026-01-31 Added note because of resistor availability
    [instrumentation_amplifier.kicad_sch]
2026-02-05 Added adc test
