BenjaminHab/mad-fine-scale/(notices)

Notices in the files:
software/Core/Src/main.cpp:
Copyright (c) 2022 STMicroelectronics.
All rights reserved.
This software is licensed under terms that can be found in the LICENSE file
